Binary-Kitchen/doorlockd/cad/case_top.stl

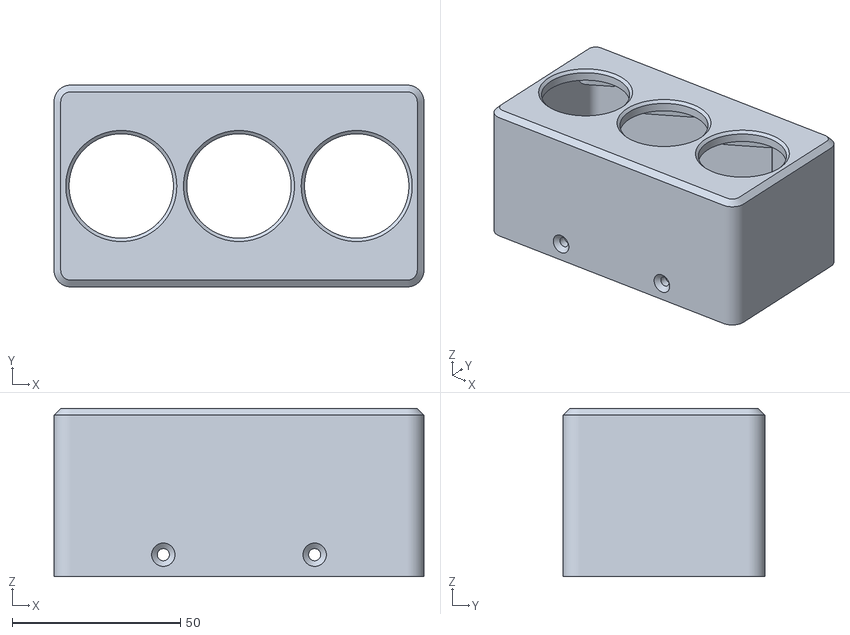
[picture p1: CAD file, 2018-09-03]
cad/case_top.stl
110.0 x 60.0 x 50.0
