Binary-Kitchen/doorlockd/cad/case_bottom.stl

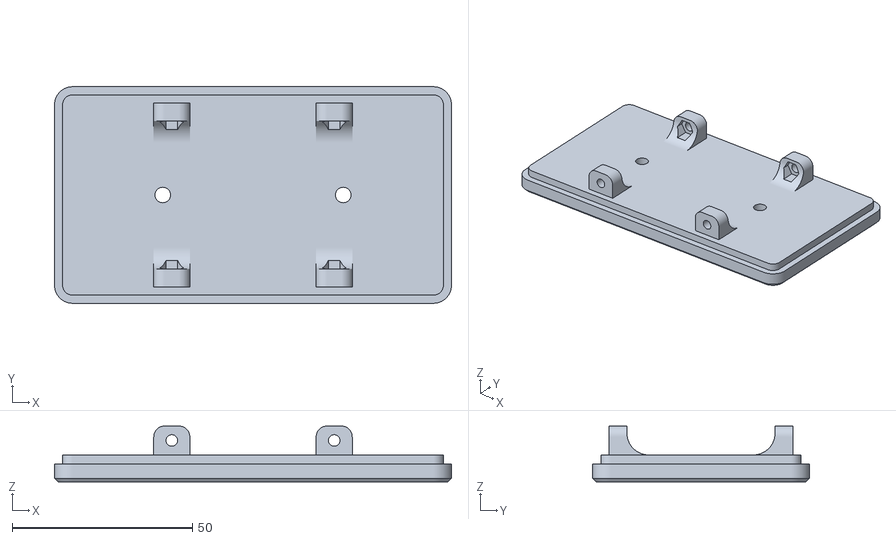
[picture p2: CAD file, 2018-09-03]
cad/case_bottom.stl
110.0 x 60.0 x 15.5
