Binary-Kitchen/doorlockd/schematics/Doorlock.brd

## EAGLE design schematics/Doorlock.brd (2018-09-09)

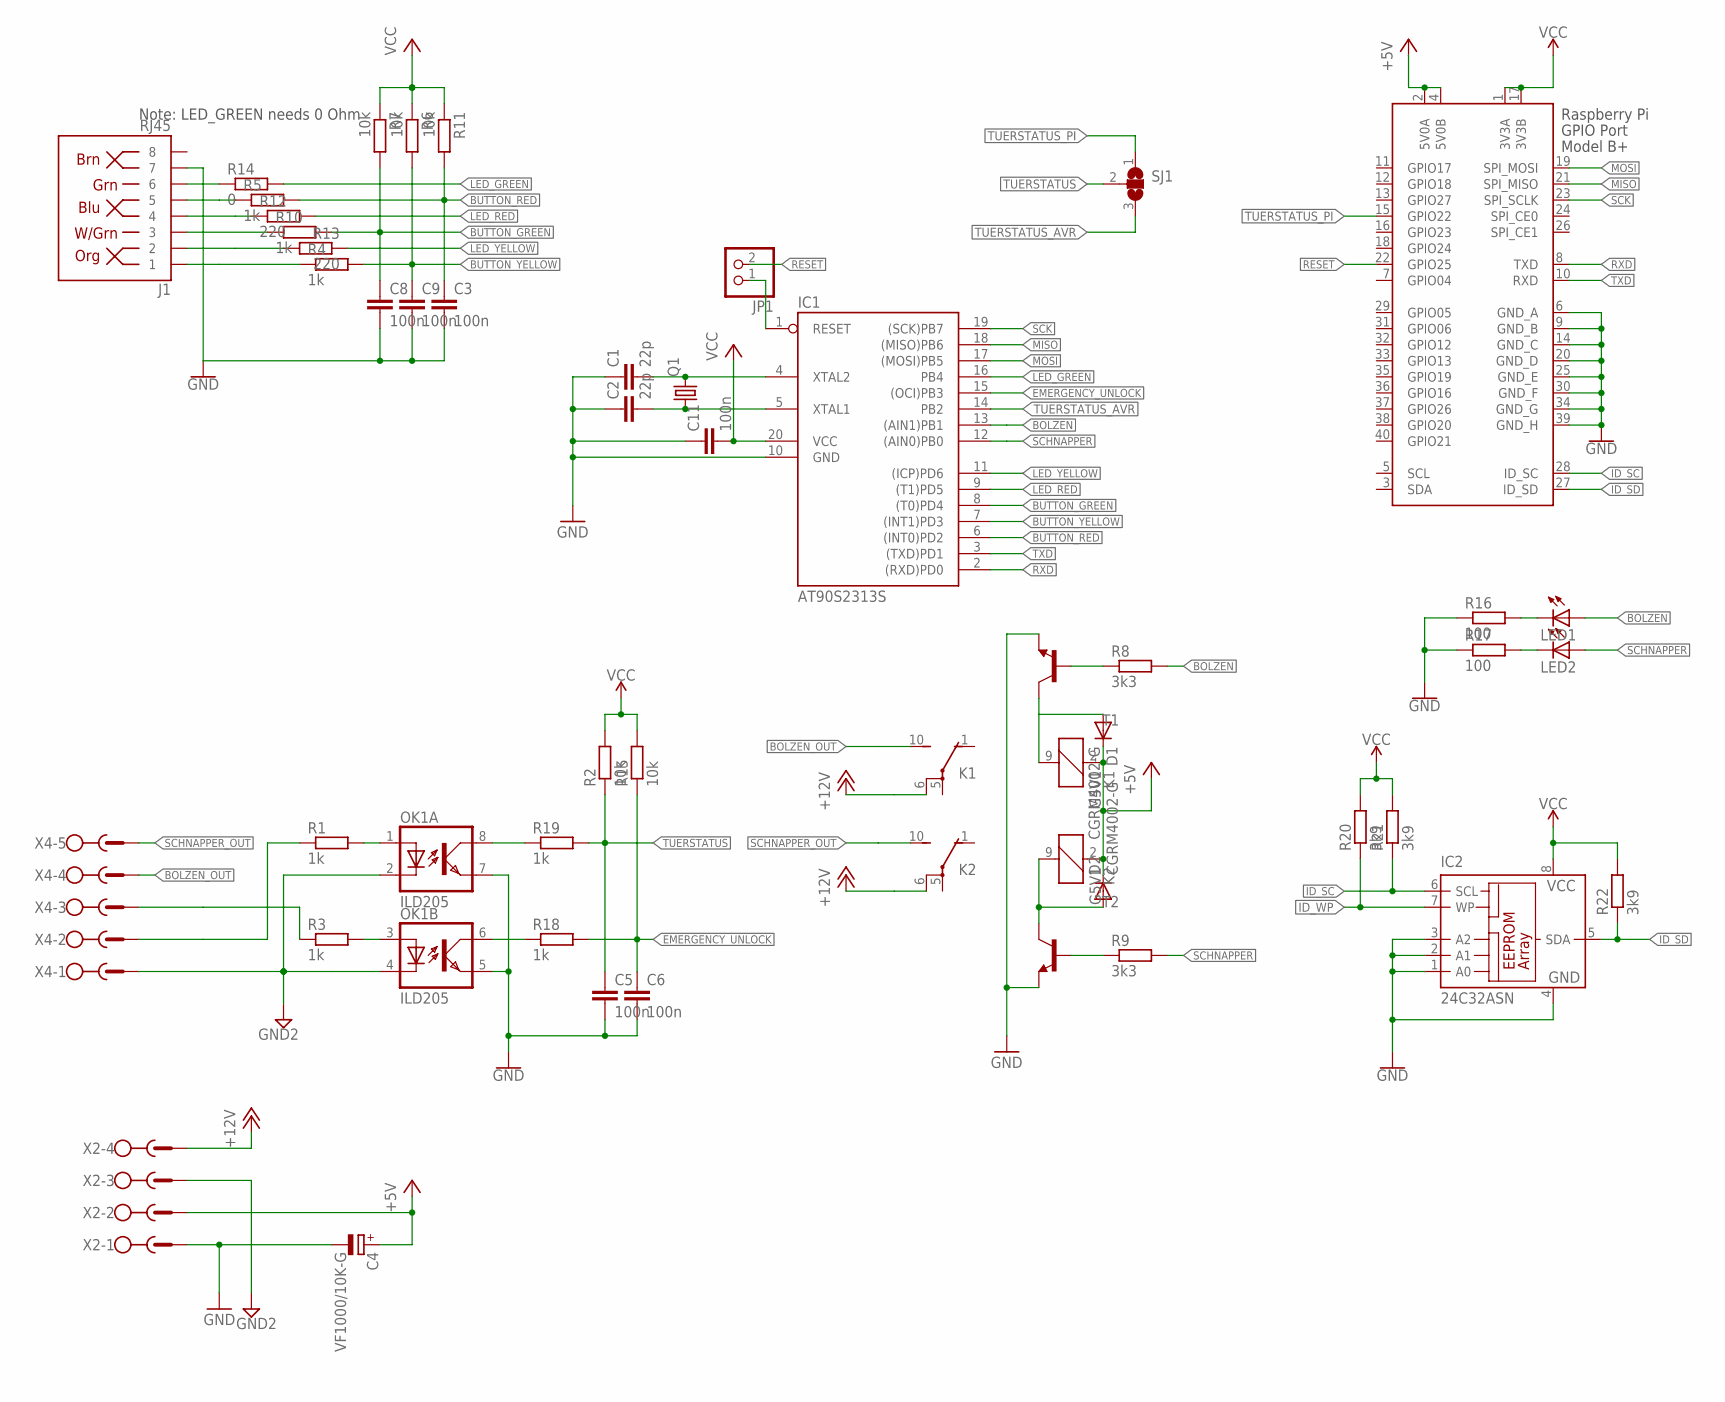
[picture p3: schematic Doorlock.sch]

Parts:
C1, C2: 22p; C0805
C3, C5, C6, C8, C9, C11: 100n; C0805
C4: VF1000/10K-G; UD-10X10_NICHICON
D1, D2: CGRM4002-G; SOD-123_MINI-SMA
IC1: AT90S2313S; SO20L
IC2: 24C32ASN; SO-08
J1: RJ45; RJ45-8
JP1: PINHD-1X2; 1X02
K1, K2: G5V1
LED1, LED2: LEDCHIP-LED0805; CHIP-LED0805
OK1: ILD205; SOIC08
Q1: CRYSTALHC49UP; HC49UP
R1, R3, R4, R5, R10, R18, R19: 1k; R0805
R2, R6, R7, R11, R15: 10k; R0805
R8, R9: 3k3; R0805
R12, R13: 220; R0805
R14: 0; R0805
R16, R17: 100; R0805
R20, R21, R22: 3k9; R0805
SJ1: SJ2W; SJ_2
T1, T2: BC817-16-NPN-SOT23-BEC; SOT23-BEC
X1: RASPI_BOARD_B+#_H; RASPI_BOARD_B+HAT
X2: RIA182-04
X4: RIA182-05

Connections:
+5V: C4.+, D1.C, D2.C, K1.2 (1), K2.2 (1), X1.2 (5V0A), X1.4 (5V0B), X2.2
+12V: K1.6, K2.6, X2.4
BOLZEN: IC1.13 ((AIN1)PB1), LED1.A, R8.2
BOLZEN_OUT: K1.10 (S), X4.4
BUTTON_GREEN: C8.1, IC1.8 ((T0)PD4), R7.2, R10.2
BUTTON_RED: C3.1, IC1.6 ((INT0)PD2), R5.2, R11.2
BUTTON_YELLOW: C9.1, IC1.7 ((INT1)PD3), R4.2, R6.2
EMERGENCY_UNLOCK: C6.1, IC1.15 ((OCI)PB3), R15.1, R18.2
GND: C1.1, C2.1, C3.2, C4.-, C5.2, C6.2, C8.2, C9.2, C11.1, IC1.10 (GND), IC2.1 (A0), IC2.2 (A1), IC2.3 (A2), IC2.4 (GND), J1.7, OK1.5 (EMIT), OK1.7 (EMIT), R16.1, R17.1, T1.E, T2.E, X1.6 (GND_A), X1.9 (GND_B), X1.14 (GND_C), X1.20 (GND_D), X1.25 (GND_E), X1.30 (GND_F), X1.34 (GND_G), X1.39 (GND_H), X2.1
GND2: OK1.2 (C), OK1.4 (C), X2.3, X4.1
ID_SC: IC2.6 (SCL), R21.1, X1.28 (ID_SC)
ID_SD: IC2.5 (SDA), R22.1, X1.27 (ID_SD)
ID_WP: IC2.7 (WP), R20.1
LED_GREEN: IC1.16 (PB4), R14.2
LED_RED: IC1.9 ((T1)PD5), R12.2
LED_YELLOW: IC1.11 ((ICP)PD6), R13.1
MISO: IC1.18 ((MISO)PB6), X1.21 (SPI_MISO)
MOSI: IC1.17 ((MOSI)PB5), X1.19 (SPI_MOSI)
unnamed: IC1.1 (RESET), JP1.1
unnamed: J1.6, R14.1
unnamed: OK1.6 (COL), R18.1
unnamed: OK1.3 (A), R3.2
unnamed: OK1.8 (COL), R19.1
unnamed: C1.2, IC1.4 (XTAL2), Q1.2
unnamed: C2.2, IC1.5 (XTAL1), Q1.1
unnamed: J1.3, R10.1
unnamed: J1.4, R12.1
unnamed: R1.1, X4.2
unnamed: J1.2, R13.2
unnamed: R3.1, X4.3
unnamed: OK1.1 (A), R1.2
unnamed: LED1.C, R16.2
unnamed: LED2.C, R17.2
unnamed: J1.1, R4.1
unnamed: J1.5, R5.1
unnamed: D2.A, K2.9 (2), T2.C
unnamed: D1.A, K1.9 (2), T1.C
unnamed: R8.1, T1.B
unnamed: R9.1, T2.B
RESET: JP1.2, X1.22 (GPIO25)
RXD: IC1.2 ((RXD)PD0), X1.8 (TXD)
SCHNAPPER: IC1.12 ((AIN0)PB0), LED2.A, R9.2
SCHNAPPER_OUT: K2.10 (S), X4.5
SCK: IC1.19 ((SCK)PB7), X1.23 (SPI_SCLK)
TUERSTATUS: C5.1, R2.1, R19.2, SJ1.2
TUERSTATUS_AVR: IC1.14 (PB2), SJ1.3
TUERSTATUS_PI: SJ1.1, X1.15 (GPIO22)
TXD: IC1.3 ((TXD)PD1), X1.10 (RXD)
VCC: C11.2, IC1.20 (VCC), IC2.8 (VCC), R2.2, R6.1, R7.1, R11.1, R15.2, R20.2, R21.2, R22.2, X1.1 (3V3A), X1.17 (3V3B)

Notes on the sheet:
Note: LED_GREEN needs 0 Ohm

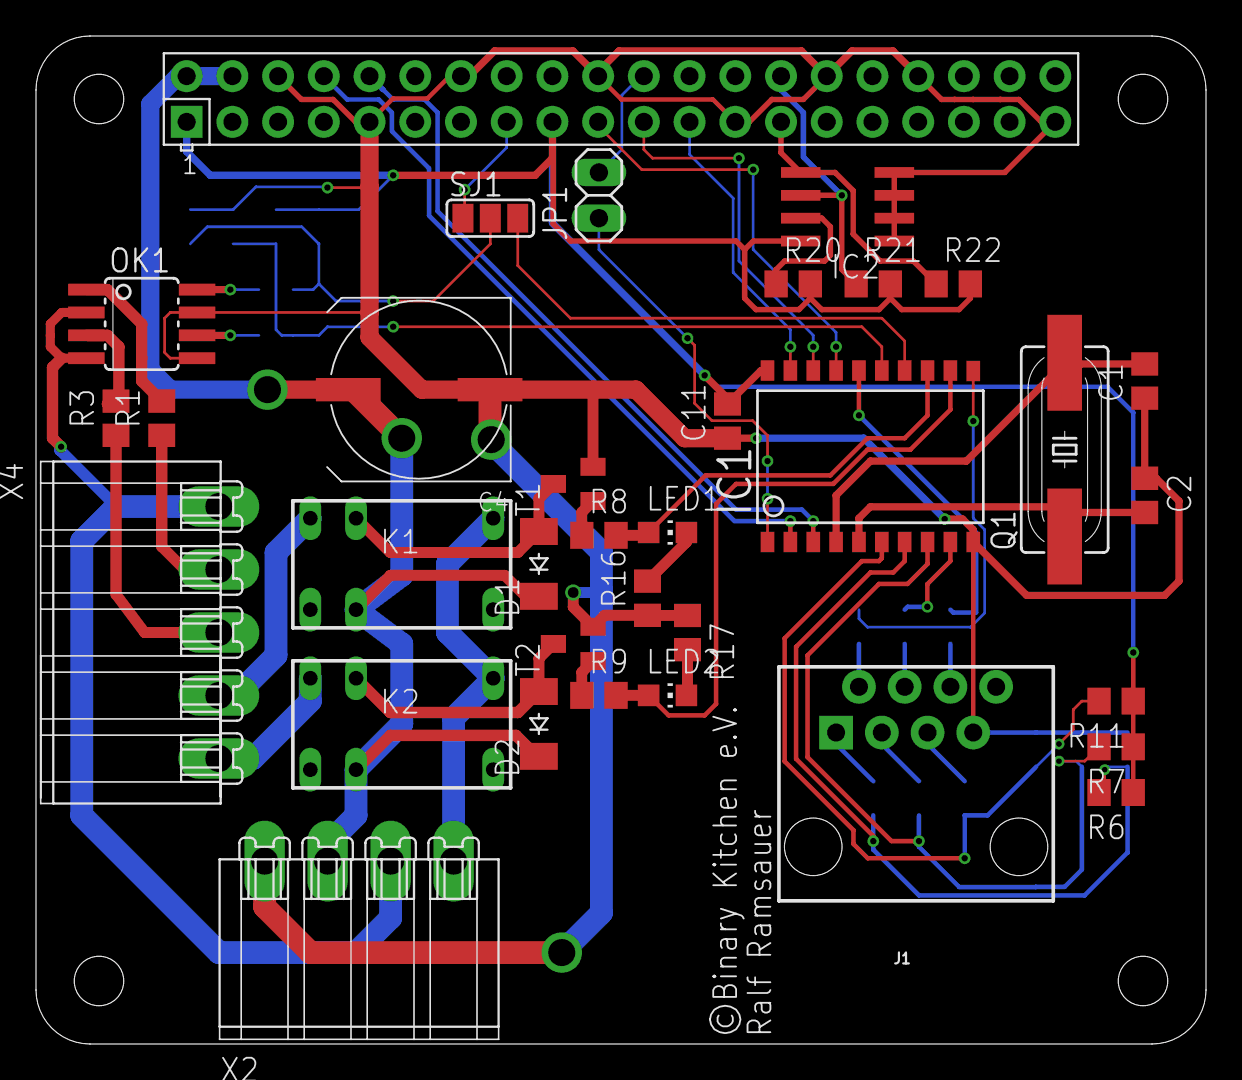
[picture p4: board Doorlock.brd from above]

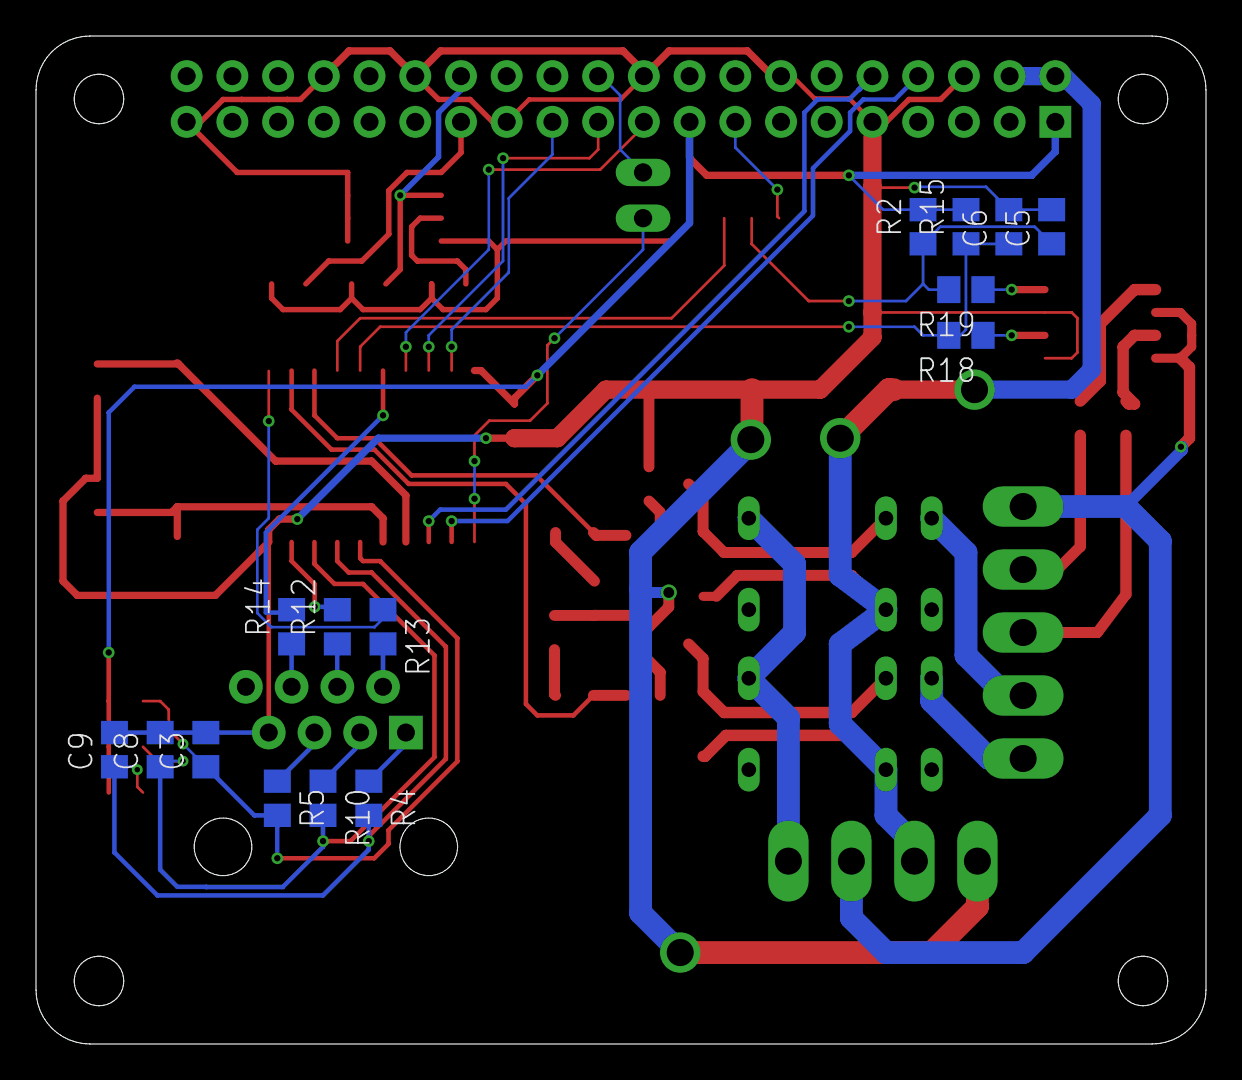
[picture p5: board Doorlock.brd from below]

Board: 2 copper layers, 65.0 x 56.0 mm, 49 parts (15 on the bottom side), 49 nets.
