Binary-Kitchen/doorlockd/(threads)

Thread 5 (2018-03-26):

Buttons don't invoke hooks

rralf, 2018-03-26:
If many buttons are pressed, the hooks are not invoked.

Reason: Code in DoorHandler is simply missing.

Reported-by: Jan-Jonas Sämann <jan-jonas.saemann@saenet.de>

rralf, 2018-03-26:
Fixed in 0ae60848cf842d2900f81fab679d8c66c1d44bb0

Closed 2018-03-26.

Thread 7 (2018-03-26):

Use CSS LEDs

rralf, 2018-03-26:
Switch to shinier CSS LEDs.

rralf, 2018-06-29:
Xaver, any updates on this? Didn't you want to implement css-based LEDs?

rralf, 2019-08-15:
Ok, I guess that's a no ;-)

xf-, 2019-09-02:
no time and i think the stuff changed a lot. i cleaned up some github stuff

rralf, 2019-09-02:
Fair enough. Let's keep this issue closed.

xf-, 2019-09-04:
you can switch the assignee or we can take a look at UI someday

Closed 2019-08-15.
