Binary-Kitchen/doorlockd/(commit log)

2015-05-13 Exchanged FIFO by TCP socket
2015-05-14 Added Schnapper functionality, added i2c and spi load stuff
2015-08-03 Added Lock Button
2015-08-27 Switched button type from open to close
2015-08-30 Added logging to close request on button press
2015-08-30 Fixed Button-close bug
2015-09-24 Added Pinout of new Board
2015-09-24 Updated board pinout
2015-09-24 removed wiringPi
2015-09-24 Rewrite of Door class
    Removed old epaper display and added stub for qrcode printing.
2015-09-24 Added schematics of controller board
    [Doorlock.brd, Doorlock.sch]
2015-09-24 Outsourced timer and external interupt initialization
2015-09-24 Implemented multi-threaded TCP session handling
2015-09-24 Bugfix
    socket might be closed after session-thread is spawned.
    socket might throw errors very early.
2015-09-29 Bugfix: QR code generation was case insensitive
    Also changed Qstring back to std::string
2015-09-30 Switched to asynchronous asio handling
2015-10-02 No schnappering on Button Unlock
    Unlock button does only release the bolzen
2015-10-05 Added new LED images and removed old templante.png
2015-10-07 Defaulted location of LED pictures
2015-10-27 Fix JSON Bug
    Json::Values do not necessarily need to be JSON objects. This Patch
    checks if the JSON::Value is in deed an object.
    Reported-by: Markus Dollinger <dolli@ignifax.de>
2016-07-31 Fix QT quirk
    So far, we used QT interfaces in a wrong way. QT is not thread safe, so
    use its signal/slot concept and move network communication stuff to a
    separate QThread.
2018-03-18 index: don't show labels for buttons
2018-03-18 socketio: deliver local static copy of scripts
2018-03-18 doorlockd.py: switch to config file
    [config.cfg]
2018-03-18 config: serve local bootstrap and jquery copies
    [config.cfg]
2018-03-18 doorlockd.py: remove argparse dependency
    by replacing its logic with flask's config parameter file.
    [config.cfg]
2018-03-18 display: Add request_status timer
    This will cyclically reset the status to Open/Close, independent of incoming
    messages
2018-03-18 doorlockd: add simulation mode
    [config.cfg]
2018-03-20 doorlockd.py: Add config parameter for hooks
    [config.cfg]
2018-03-22 config: don't run hooks
    For the moment, don't run hooks
    [config.cfg]
2018-03-22 doorlockd.py: Add LDAP authentication support
    Shamelessly copied from moep's DSS tool.
    Cc: Markus Hauschild <moepman@binary-kitchen.de>
    [config.cfg]
2018-03-23 doorlockd.py: add doorlock sounds
    [config.cfg]
2018-03-23 remove old code
    [config.cfg]
2018-04-03 changed socketio async mode from None to 'threading' in order to function correctly with python threads
2018-08-23 doorlockd: Implement doorlock API
    This will be used in the future Android App.
    /api only allows POST requests. POST variables:
    - user
    - pass
    - command
    Supported commands: "status", "lock", "unlock"
    Only valid API requests (i.e., an API request that has all POST variables set)
    will respons a valid JSON response. Otherwise, an html error will be thrown.
    JSON response format:
    err: Integer, Error code, as defined in LogicResponse
    msg: Message
    status: Current kitchen status. Only set in case of success.
    The LogicResponse stati "Success", "AlreadyLocked" and "AlreadyUnlocked" are
    considered successful.
2018-09-02 Split up simulation of LDAP and serial
    [config.cfg]
2018-09-02 First steps towards Raspberry Pi doorlock hat
    [Doorlock.brd, Doorlock.sch]
2018-09-03 Add the current state to the response
2018-09-03 Remove ISP adapter
    Let's flash the device with the Raspberry Pi :-)
    ... But add an Jumper for the reset line.
    [Doorlock.brd, Doorlock.sch]
2018-09-03 avr: add accessors for emergency buttons
2018-09-03 Design a button case
    [case.cfg, case_bottom.stl, case_top.stl]
2018-09-05 Rename config.cfg -> doorlockd.cfg
    [doorlockd.cfg]
2018-09-05 move sound specification from config to source
    [doorlockd.cfg]
2018-09-07 doorlockd: Flask: disable use_reloader
    This spawns the process twice which duplicates the UART thread, which,
    of course, leads to silly races.
2018-09-07 schematics: improve schematics
    - Use RJ45 instead for buttons/LEDs
    - Use SMD capacitor
    [Doorlock.brd, Doorlock.sch]
2018-09-08 schematics: Update Resistor values
    [Doorlock.brd, Doorlock.sch]
2018-09-08 schematics: decouple optocoupler
    [Doorlock.brd, Doorlock.sch]
2018-09-08 schematics: board: rearrange LEDs
    [Doorlock.brd]
2018-09-08 schematics: add door state jumper
    [Doorlock.brd, Doorlock.sch]
2018-09-08 schematics: board: move RJ45 jack to the left
    [Doorlock.brd]
2018-09-08 schematics: board: minor fixes
    Credits go to Noby for the review!
    [Doorlock.brd]
2018-09-09 schematics: add Raspberry Pi Hat EEPROM
    [Doorlock.brd, Doorlock.sch]
2018-09-09 schematics: board: minor fixups
    [Doorlock.brd]
2018-09-09 schematics: Add BOM and Reichelt link
2018-09-17 Parameterise more settings
    [doorlockd.cfg]
2018-09-17 doorlockd: backend: support local authentication
    [doorlockd.cfg]
2018-09-17 doorlockd: amend default config path for local credential storage
    [doorlockd.cfg]
2018-10-06 avr: Add fuse rule to Makefile
2018-10-06 avr: reverse bolzen logic
    And set initial state
    [main.c]
2018-10-07 doorlockd: remove superfluous code
    No more users, drop it.
    [doorlockd.cfg]
2018-10-16 pydoorlock: switch to new config parser
    We want to use doorlockd for more than just serving webapps. Get rid of the
    Flask config parser and use python's own config parser.
    [doorlockd.cfg, doorlockd.default.cfg]
2018-10-16 fix doorlockd config
    [doorlockd.cfg, doorlockd.default.cfg]
2018-10-16 doorlockd.default.cfg: fall back to default settings
    [doorlockd.default.cfg]
2018-10-18 configs: fix RUN_HOOKS
    [doorlockd.default.cfg]
2019-02-22 doorlockd.cfg: move comment
    It's at the wrong place...
    [doorlockd.cfg]
2019-06-14 pydoorlock: Config: Only use one config file
    [doorlockd.cfg, doorlockd.default.cfg]
2019-06-15 Introduce etc directory
    [doorlockd.cfg]
2019-06-15 Config: allow multiple config topics
    [doorlockd.cfg]
2019-06-23 doorstate: reimplement doorstate in python
    Furthermore, add initial support for the alarm topic.
    [doorlockd.cfg]
2019-07-07 doorstate: automatically reconnect if mqtt broker fails
    We had a bug: doorstate didn't reconnect to the broker if it temporarily
    disappeared.
    Fix this by using start_loop() (which starts a thread that observes the
    broker and automatically reconnects) instead of the synchronous loop()
    method.
    Thomas Basler <github.thomas@familie-basler.net>
2020-11-12 Remove socket.io dependency and use http server sent events instead
2022-12-08 Authenticator: Add blacklist
    [doorlockd.cfg]
