Binary-Kitchen/doorlockd/(notices)

Notices in the files:
schematics/Doorlock.brd:
©Binary Kitchen e.V.
parts and their libraries:
SparkFun-PowerSymbols: Licensing: Creative Commons ShareAlike 4.0 International - https://creativecommons.org/licenses/by-sa/4.0
